amzol32/-CPE027-/docs/img/dashboard_desktop.png

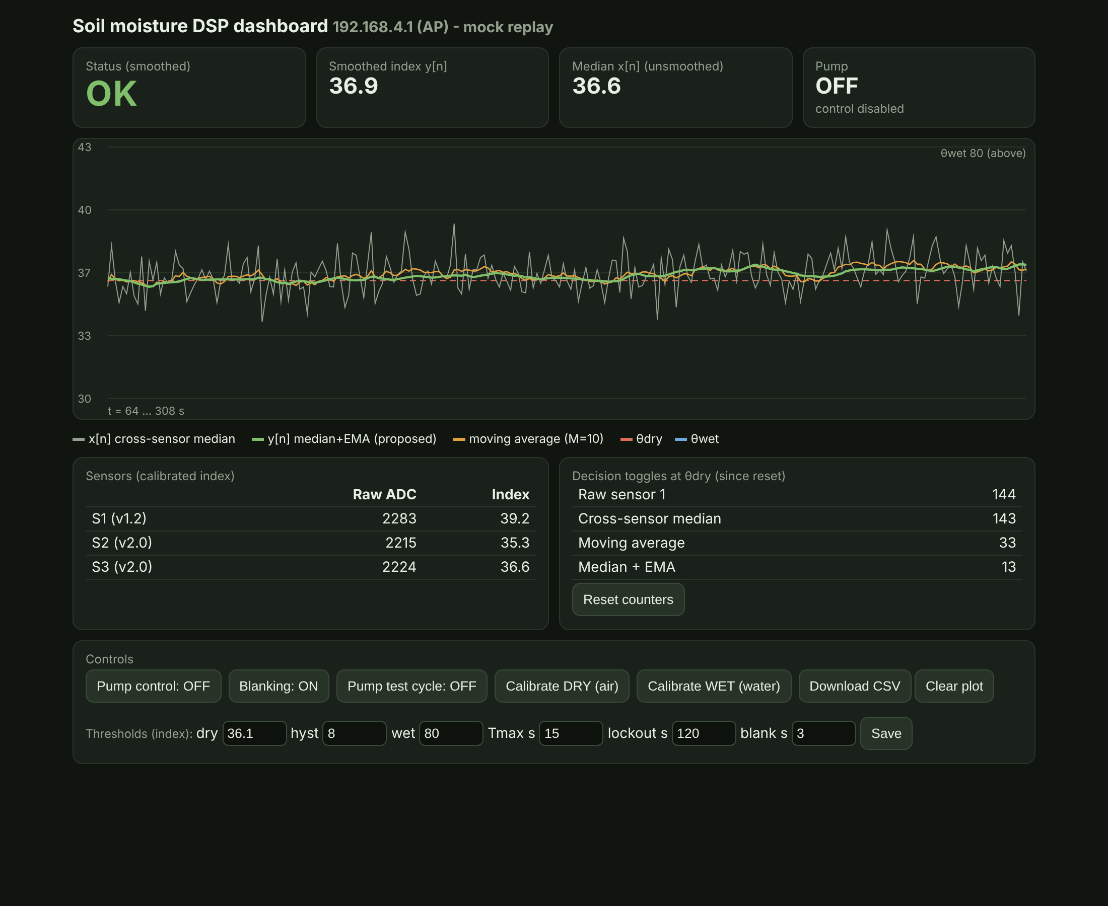
docs/img/dashboard_desktop.png
