amzol32/-CPE027-/docs/img/dashboard_phone.png

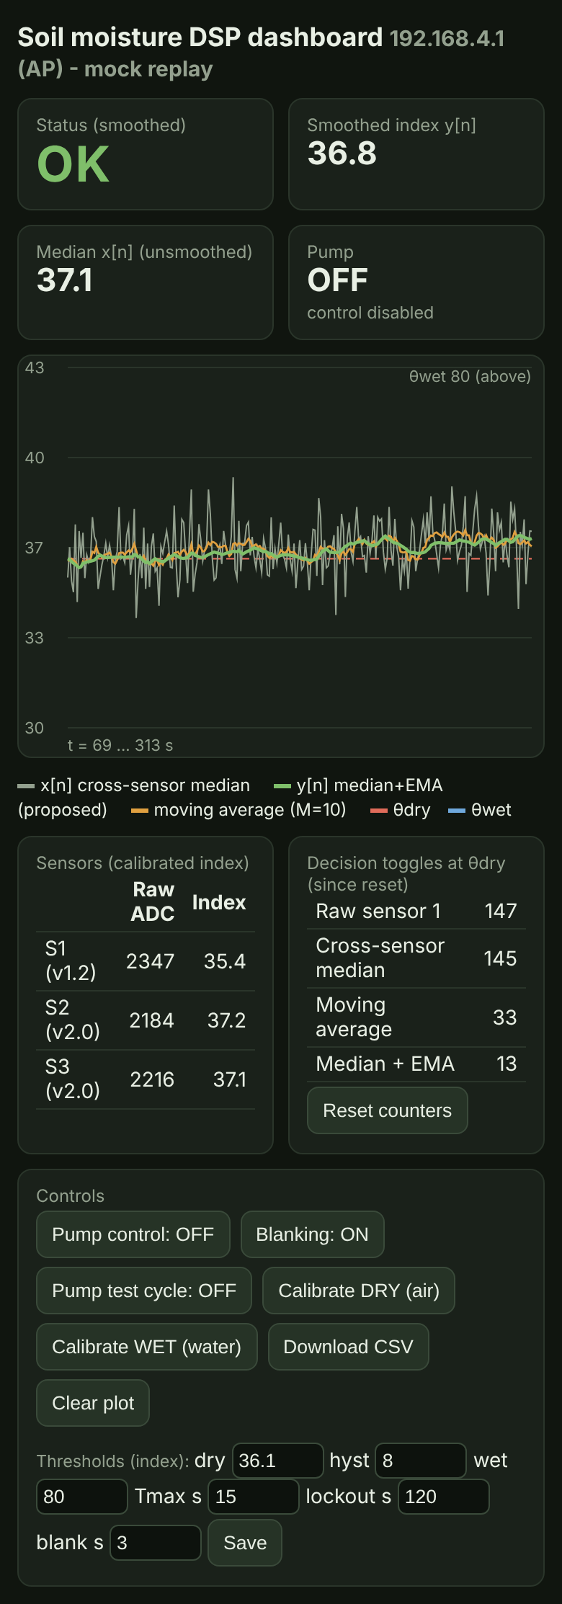
docs/img/dashboard_phone.png
