amzol32/-CPE027-/firmware/soil_dsp/secrets.example.h

// Copy this file to secrets.h (same folder) and fill in your Wi-Fi. secrets.h is git-ignored.
// If secrets.h is missing or the network cannot be joined in 15 s, the board starts its own
// access point instead:  SSID "SoilDSP"  password "soildsp123"  ->  http://192.168.4.1/
#pragma once
#define WIFI_SSID "your-wifi-name"
#define WIFI_PASS "your-wifi-password"
