amzol32/-CPE027-/(commit log)

2026-10-28 v0.4: ESP32-S3 firmware (3-sensor pipeline, calibration, relay safety logic, TFT, web dashboard, CSV log) with host simulation and CI
2026-10-28 v0.3: analysis tooling (Tables 6-1..6-3, spectrum, pump test), numpy reference, firmware cross-check, synthetic logs (simulated, not results)
    [synthetic_calib_air.csv, synthetic_calib_water.csv, synthetic_pump.csv, synthetic_steady.csv, synthetic_step.csv]
2026-10-28 v0.2: portable DSP core (median3, running median, EMA, moving average, pump controller) with unit tests
2026-10-28 v0.1: baseline 3-sensor read-out and relay test (original working sketch)
2026-10-29 v0.4.1: verified ESP32-S3 build, dashboard browser check, prebuilt image
    - fix: rename global `pipe` to `dspPipe`; it clashed with POSIX pipe() and broke the real ESP32-S3 build
    - tests: Arduino stub now includes unistd.h so that kind of clash is caught on the PC
    - dashboard: y-axis follows the data (thresholds far from it are noted, not plotted), canvas sized for
    high-DPI/phone screens, redraw on resize
    - tests: dashboard_mock.py serves the real page with a replayed log; dashboard_check.js checks it in Chromium
    - firmware/prebuilt: flashable merged image (core 3.0.7) with flashing notes
    - ci: pin esp32 core 3.0.7, compile with --warnings all
    - docs: verification status, UART-port note for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
    [soil_dsp.ino]
